mvegh/arduino-watchwinder/img/05.in_the_box.jpg

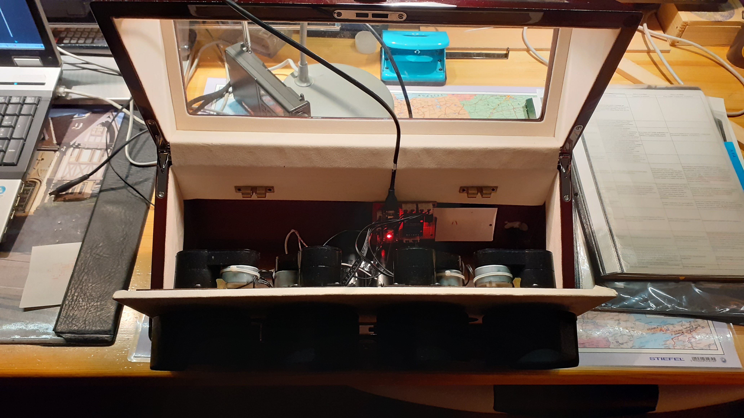
img/05.in_the_box.jpg
