mvegh/arduino-watchwinder/img/03.powerup-test.jpg

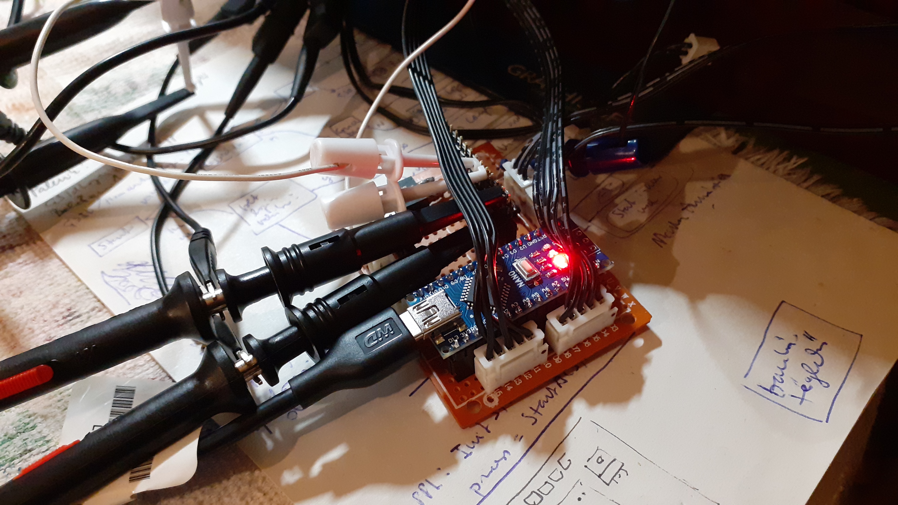
img/03.powerup-test.jpg
